p01aris/ELTerm_LJ64/hardware/ELTerm.kicad_pcb

## KiCad design hardware/ELTerm.kicad_pcb (2023-10-17)

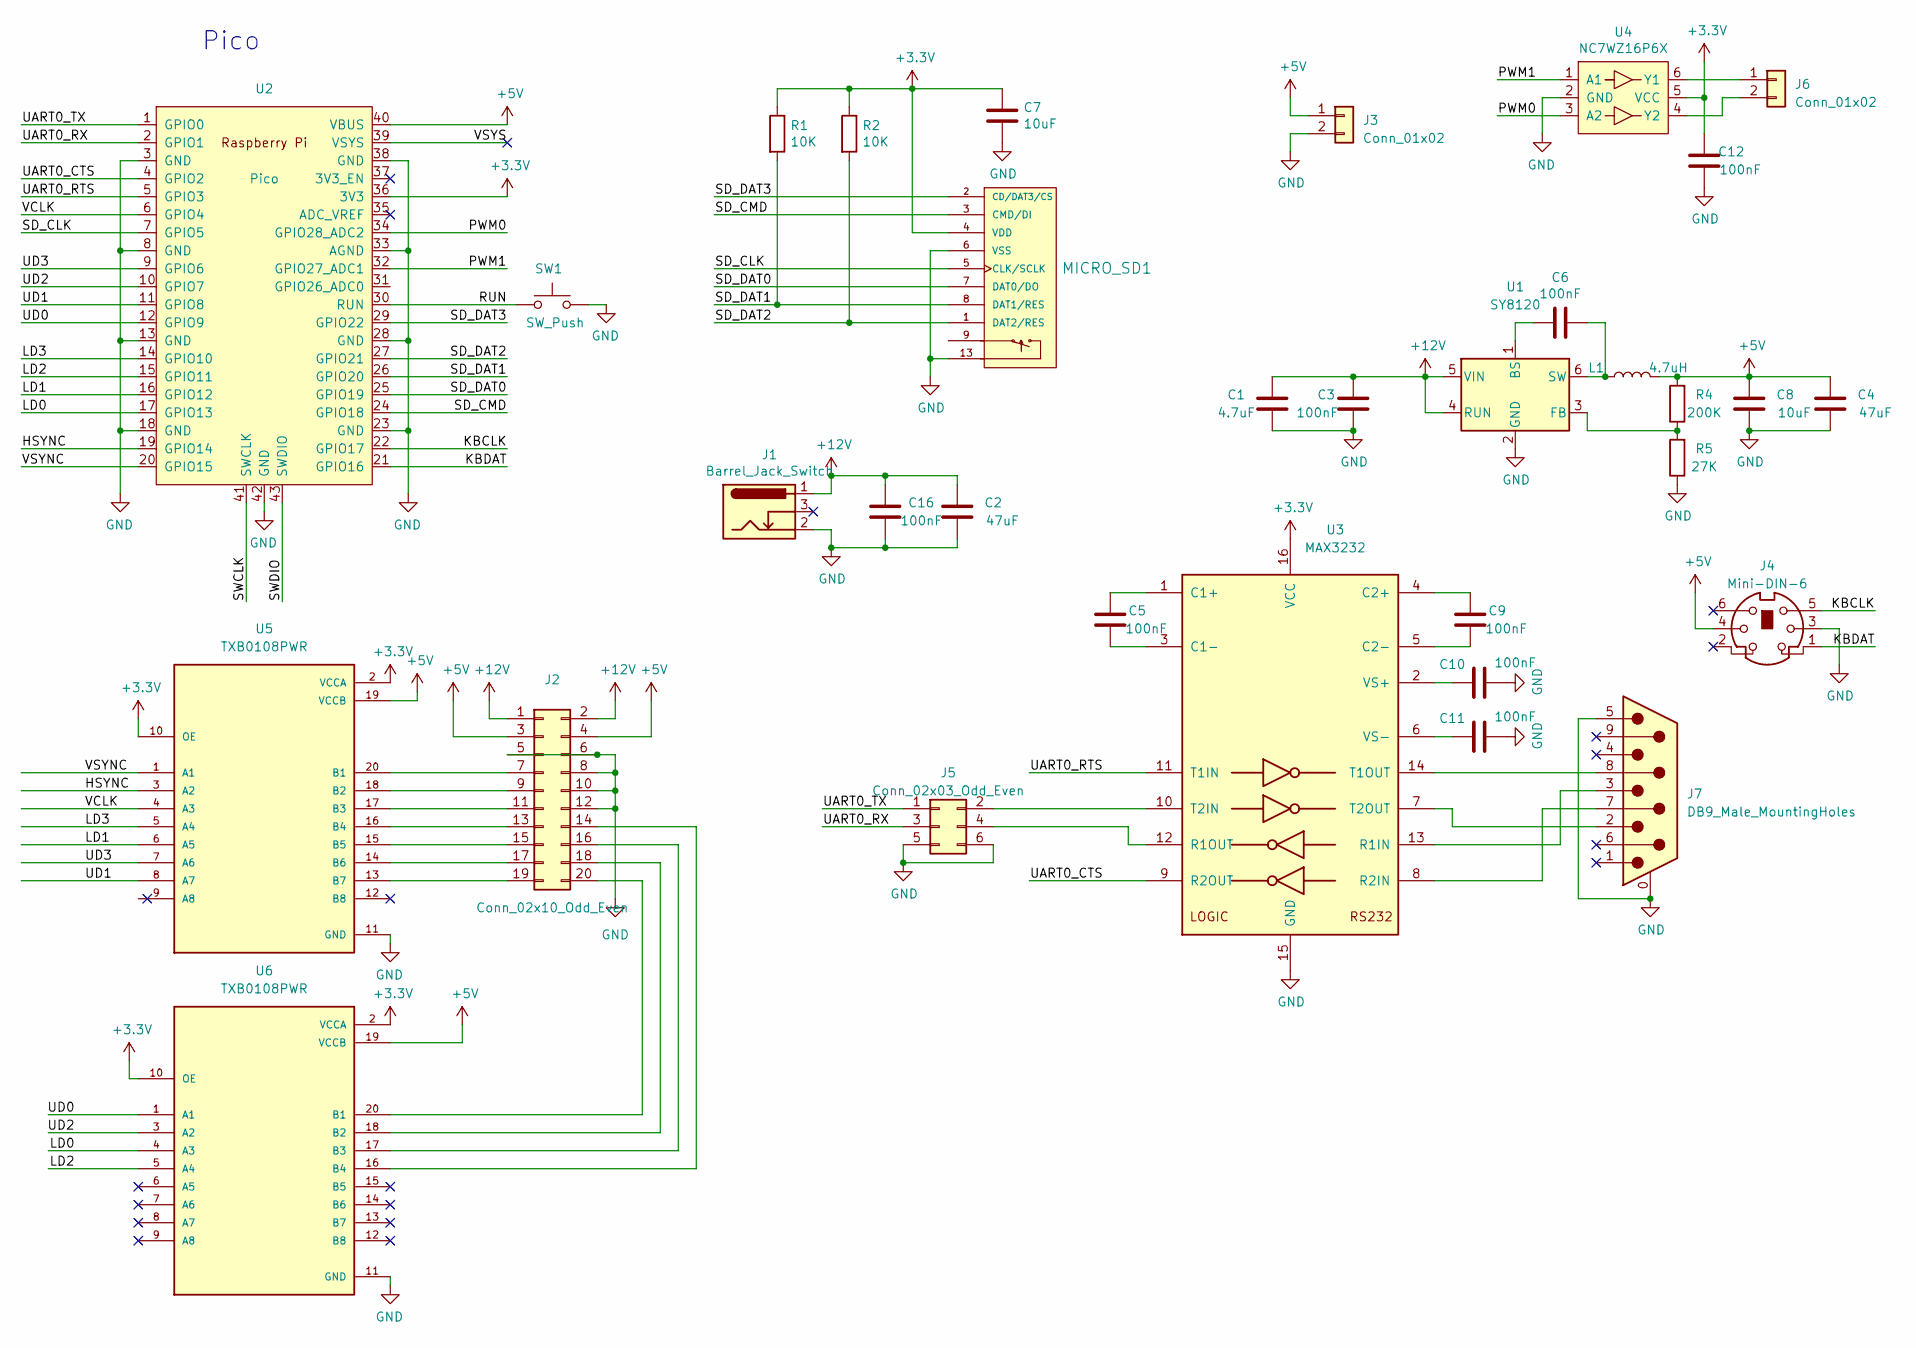
[picture p1: schematic ELTerm.kicad_sch]

Parts:
C1: 4.7uF; C_0805_2012Metric
C2, C4: 47uF; C_Elec_5x5.8
C3, C5, C6, C9, C10, C11, C12, C16: 100nF; C_0603_1608Metric
C7, C8: 10uF; C_0603_1608Metric
J1: Barrel_Jack_Switch; BarrelJack_Horizontal
J2: Conn_02x10_Odd_Even; PinHeader_2x10_P2.00mm_Vertical
J3, J6: Conn_01x02; PinHeader_1x02_P2.54mm_Vertical
J4: Mini-DIN-6; MINI-DIN-6-FULL-SHIELD
J5: Conn_02x03_Odd_Even; PinHeader_2x03_P2.54mm_Vertical
J7: DB9_Male_MountingHoles; DSUB-9_Male_Horizontal_P2.77x2.84mm_EdgePinOffset4.94mm_Hou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
L1: 4.7uH; L_Vishay_IHLP-1212
MICRO_SD1: MICRO_SD(TFC-WPAPR-08); TFC-WPAPR-08
R1, R2: 10K; R_0603_1608Metric
R4: 200K; R_0603_1608Metric
R5: 27K; R_0603_1608Metric
SW1: SW_Push; SW_SPST_CK_RS282G05A3
U1: SY8120; TSOT-23-6
U2: Pico; RPi_Pico_SMD_TH
U3: MAX3232; SO-16_3.9x9.9mm_P1.27mm
U4: NC7WZ16P6X; SOT-363_SC-70-6
U5, U6: TXB0108PWR; SOP65P640X120-20N

Connections:
+3V3: C7.1, C12.2, MICRO_SD1.4 (VDD), R1.1, R2.1, U2.36 (3V3), U3.16 (VCC), U4.5 (VCC), U5.2 (VCCA), U5.10 (OE), U6.2 (VCCA), U6.10 (OE)
+5V: C4.2, C8.2, J2.3, J2.4, J3.1, J4.4, L1.2, R4.2, U2.40 (VBUS), U5.19 (VCCB), U6.19 (VCCB)
+12V: C1.2, C2.2, C3.2, C16.2, J1.1, J2.1, J2.2, U1.4 (RUN), U1.5 (VIN)
/HSYNC: U2.19 (GPIO14), U5.3 (A2)
/KBCLK: J4.5, U2.22 (GPIO17)
/KBDAT: J4.1, U2.21 (GPIO16)
/LD0: U2.17 (GPIO13), U6.4 (A3)
/LD1: U2.16 (GPIO12), U5.6 (A5)
/LD2: U2.15 (GPIO11), U6.5 (A4)
/LD3: U2.14 (GPIO10), U5.5 (A4)
/PWM0: U2.34 (GPIO28_ADC2), U4.3 (A2)
/PWM1: U2.32 (GPIO27_ADC1), U4.1 (A1)
/RUN: SW1.1, U2.30 (RUN)
/SD_CLK: MICRO_SD1.5 (CLK/SCLK), U2.7 (GPIO5)
/SD_CMD: MICRO_SD1.3 (CMD/DI), U2.24 (GPIO18)
/SD_DAT0: MICRO_SD1.7 (DAT0/DO), U2.25 (GPIO19)
/SD_DAT1: MICRO_SD1.8 (DAT1/RES), R1.2, U2.26 (GPIO20)
/SD_DAT2: MICRO_SD1.1 (DAT2/RES), R2.2, U2.27 (GPIO21)
/SD_DAT3: MICRO_SD1.2 (CD/DAT3/CS), U2.29 (GPIO22)
/SWCLK: U2.41 (SWCLK)
/SWDIO: U2.43 (SWDIO)
/UART0_CTS: U2.4 (GPIO2), U3.9 (R2OUT)
/UART0_RTS: U2.5 (GPIO3), U3.11 (T1IN)
/UART0_RX: J5.3, U2.2 (GPIO1)
/UART0_TX: J5.1, U2.1 (GPIO0)
/UD0: U2.12 (GPIO9), U6.1 (A1)
/UD1: U2.11 (GPIO8), U5.8 (A7)
/UD2: U2.10 (GPIO7), U6.3 (A2)
/UD3: U2.9 (GPIO6), U5.7 (A6)
/VCLK: U2.6 (GPIO4), U5.4 (A3)
/VSYNC: U2.20 (GPIO15), U5.1 (A1)
/VSYS: U2.39 (VSYS)
GND: C1.1, C2.1, C3.1, C4.1, C7.2, C8.1, C10.1, C11.1, C12.1, C16.1, J1.2, J2.5, J2.6, J2.8, J2.10, J2.12, J3.2, J4.3, J5.5, J5.6, J7.0 (PAD), J7.5, MICRO_SD1.6 (VSS), MICRO_SD1.10, MICRO_SD1.11, MICRO_SD1.12, MICRO_SD1.13, R5.1, SW1.2, U1.2 (GND), U2.3 (GND), U2.8 (GND), U2.13 (GND), U2.18 (GND), U2.23 (GND), U2.28 (GND), U2.33 (AGND), U2.38 (GND), U2.42 (GND), U3.15 (GND), U4.2 (GND), U5.11 (GND), U6.11 (GND)
unnamed: J2.7, U5.20 (B1)
unnamed: J2.9, U5.18 (B2)
unnamed: J2.11, U5.17 (B3)
unnamed: J2.13, U5.16 (B4)
unnamed: J2.14, U6.16 (B4)
unnamed: J2.15, U5.15 (B5)
unnamed: J2.16, U6.17 (B3)
unnamed: J2.17, U5.14 (B6)
unnamed: J2.18, U6.18 (B2)
unnamed: J2.19, U5.13 (B7)
unnamed: J2.20, U6.20 (B1)
unnamed: J5.2, U3.10 (T2IN)
unnamed: J5.4, U3.12 (R1OUT)
unnamed: J6.1, U4.6 (Y1)
unnamed: J6.2, U4.4 (Y2)
unnamed: C6.2, U1.1 (BS)
unnamed: R4.1, R5.2, U1.3 (FB)
unnamed: C6.1, L1.1, U1.6 (SW)
unnamed: C5.2, U3.1 (C1+)
unnamed: C5.1, U3.3 (C1-)
unnamed: C9.2, U3.4 (C2+)
unnamed: C9.1, U3.5 (C2-)
unnamed: J7.3, U3.13 (R1IN)
unnamed: J7.7, U3.8 (R2IN)
unnamed: J7.8, U3.14 (T1OUT)
unnamed: J7.2, U3.7 (T2OUT)
unnamed: C10.2, U3.2 (VS+)
unnamed: C11.2, U3.6 (VS-)

Notes on the sheet:
Pico

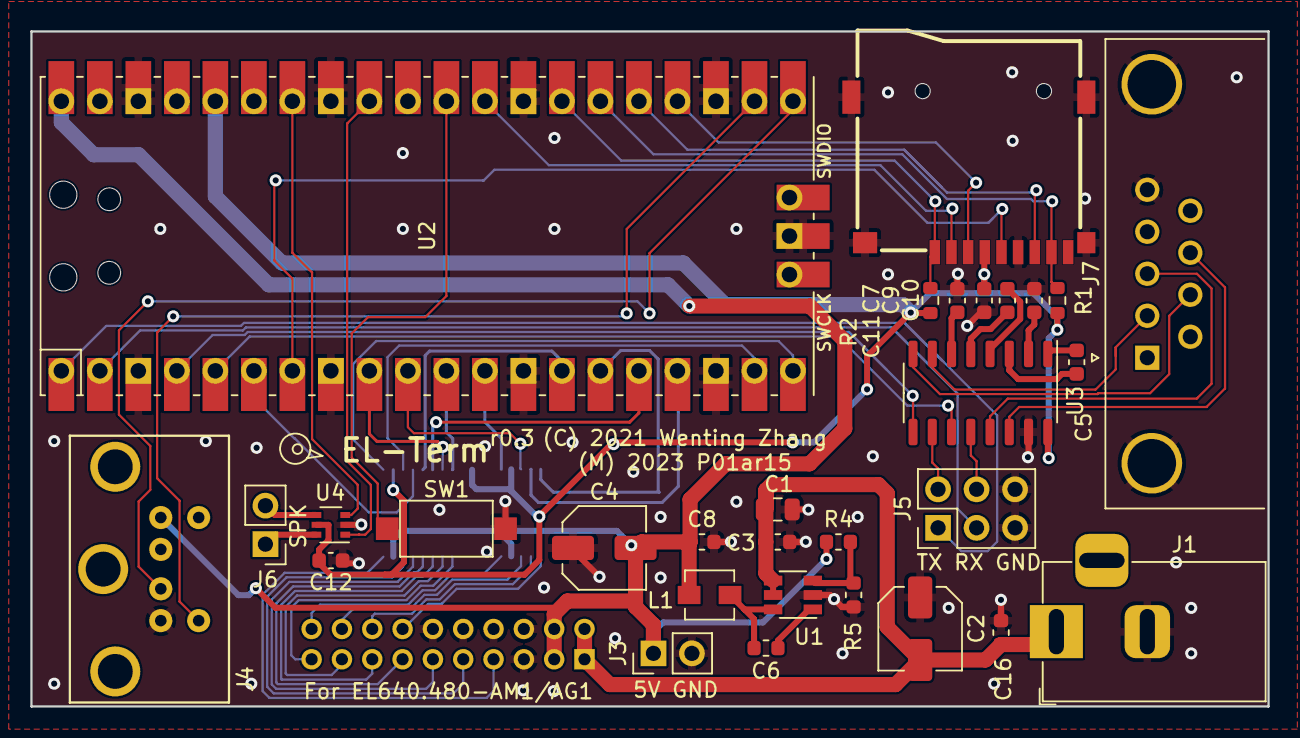
[picture p2: board ELTerm.kicad_pcb from above]

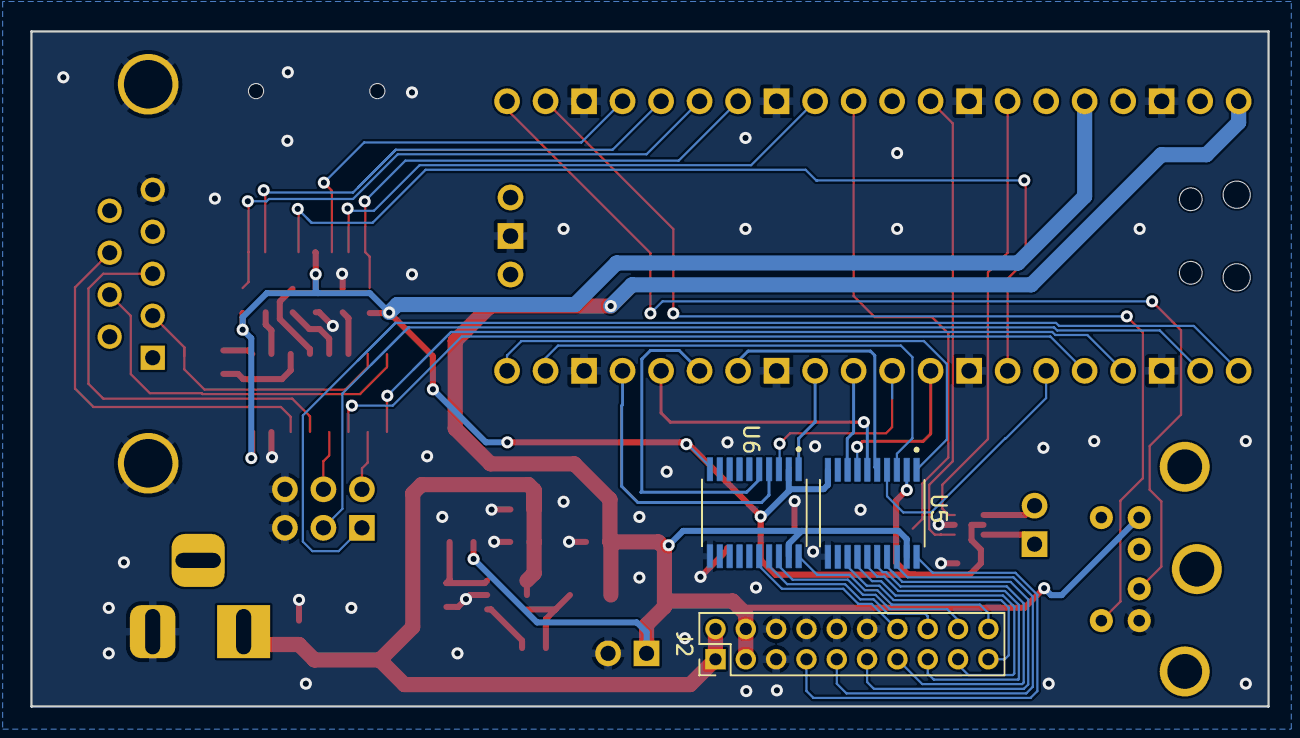
[picture p3: board ELTerm.kicad_pcb from below]

Board: 2 copper layers, 81.6 x 44.5 mm, 33 parts (3 on the bottom side), 58 nets.
